ricardo-de-andrade/gemini-robot-pi5/3dprint/Raspberry Cover - Jetpack.3mf

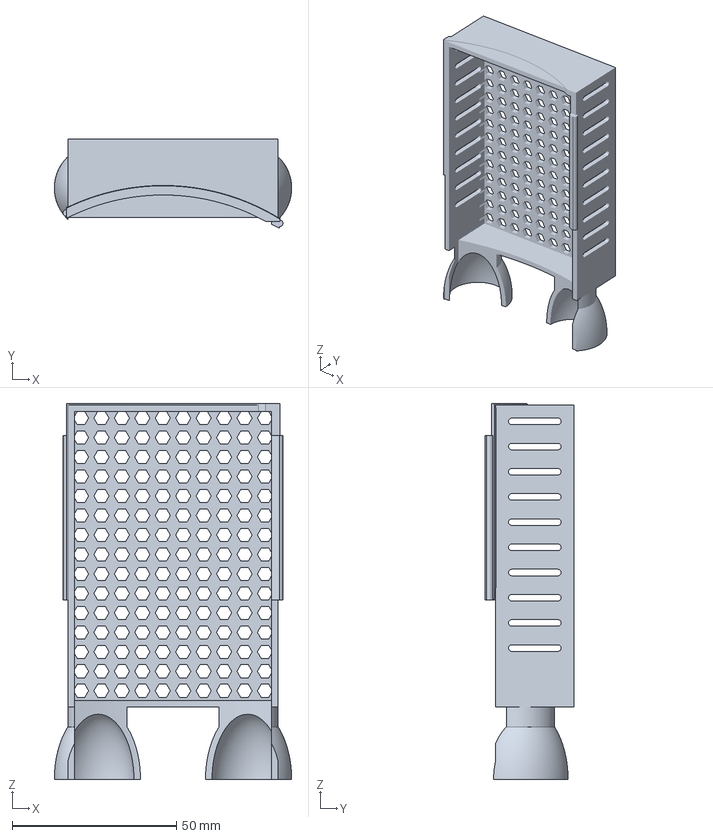
[picture p1: CAD file, 2026-10-08]
3dprint/Raspberry Cover - Jetpack.3mf
72.2 x 27.2 x 114.4 mm
