ricardo-de-andrade/gemini-robot-pi5/3dprint/BugDroid - Legs.3mf

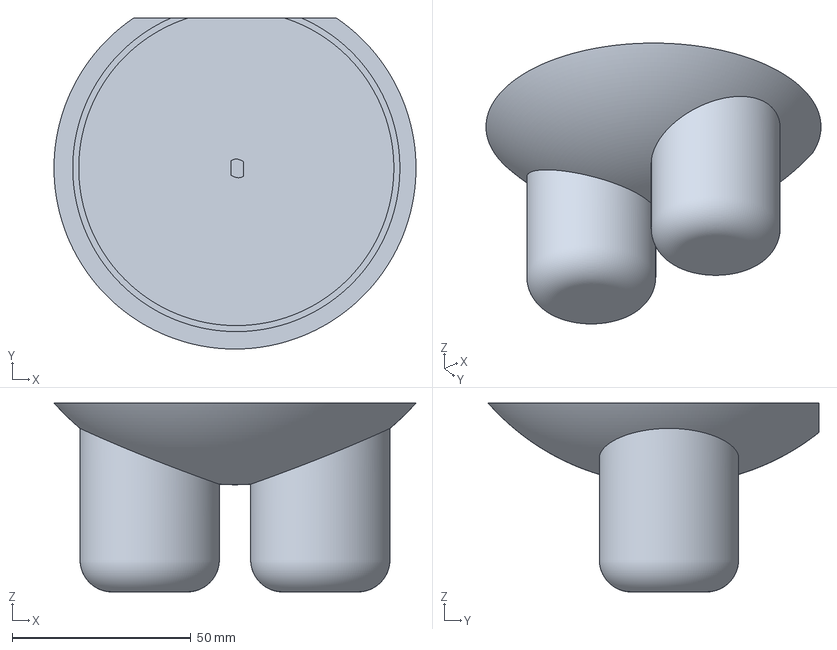
[picture p2: CAD file, 2026-10-08]
3dprint/BugDroid - Legs.3mf
101.3 x 92.7 x 52.9 mm
