ricardo-de-andrade/gemini-robot-pi5/3dprint/BugDroid - Arms.3mf

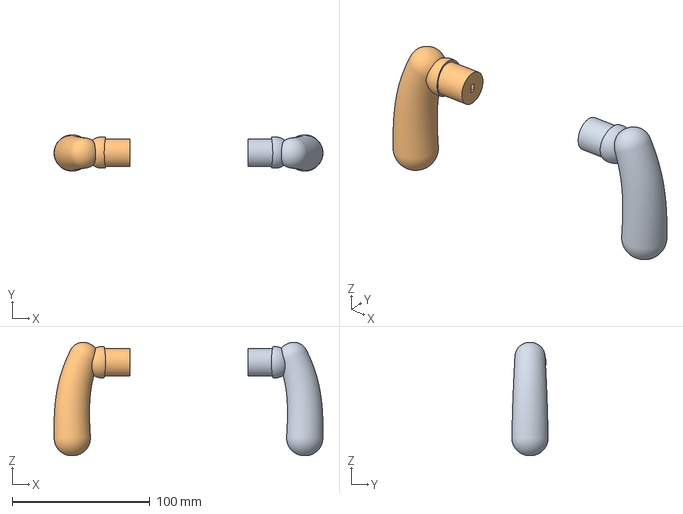
[picture p3: CAD file, 2026-10-08]
3dprint/BugDroid - Arms.3mf
195.6 x 26.4 x 82.5 mm
Left Arm
Right Arm
