ricardo-de-andrade/gemini-robot-pi5/3dprint/Motor Mount.3mf

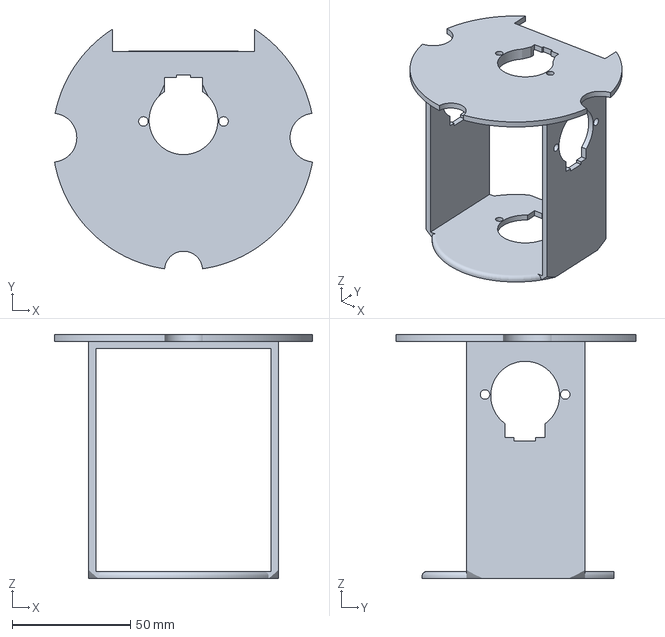
[picture p4: CAD file, 2026-10-08]
3dprint/Motor Mount.3mf
108.9 x 101.1 x 103.0 mm
