ricardo-de-andrade/gemini-robot-pi5/3dprint/BugDroid - Head.3mf

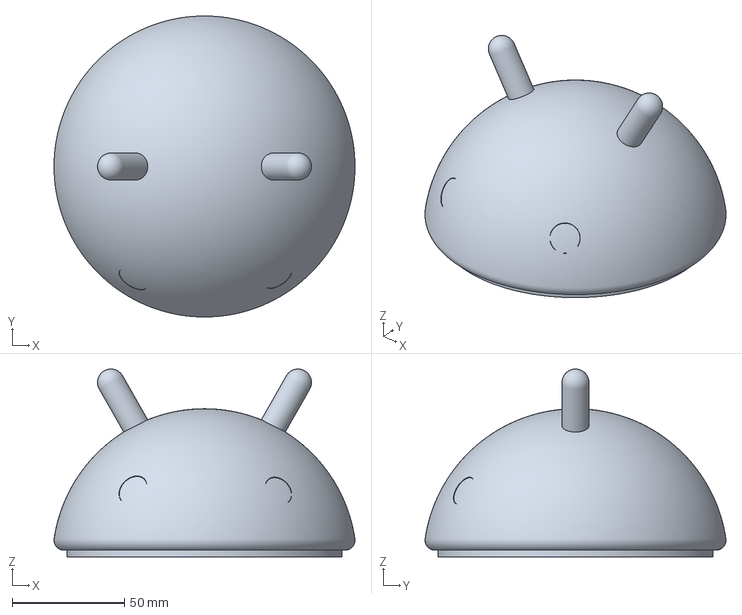
[picture p5: CAD file, 2026-10-08]
3dprint/BugDroid - Head.3mf
134.0 x 134.0 x 83.7 mm
