ricardo-de-andrade/gemini-robot-pi5/3dprint/BugDroid - Body.3mf

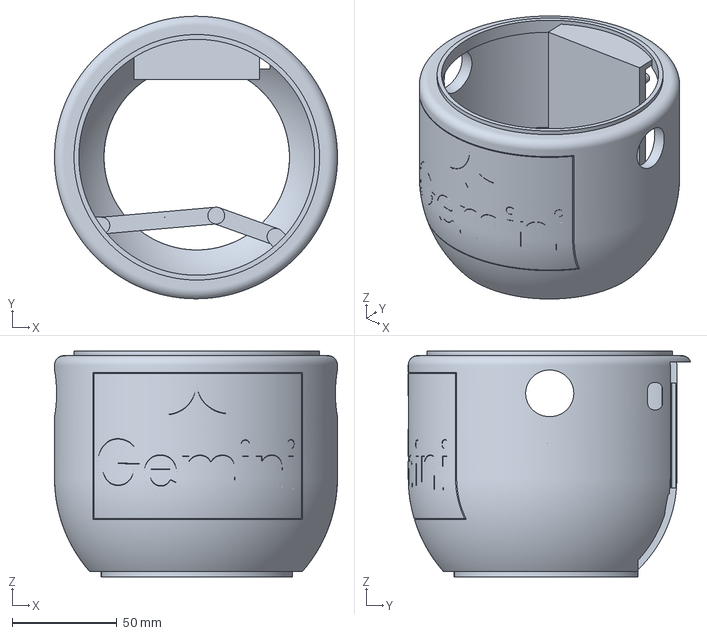
[picture p6: CAD file, 2026-10-08]
3dprint/BugDroid - Body.3mf
135.0 x 134.8 x 107.8 mm
