ricardo-de-andrade/gemini-robot-pi5/3dprint/Android.stl

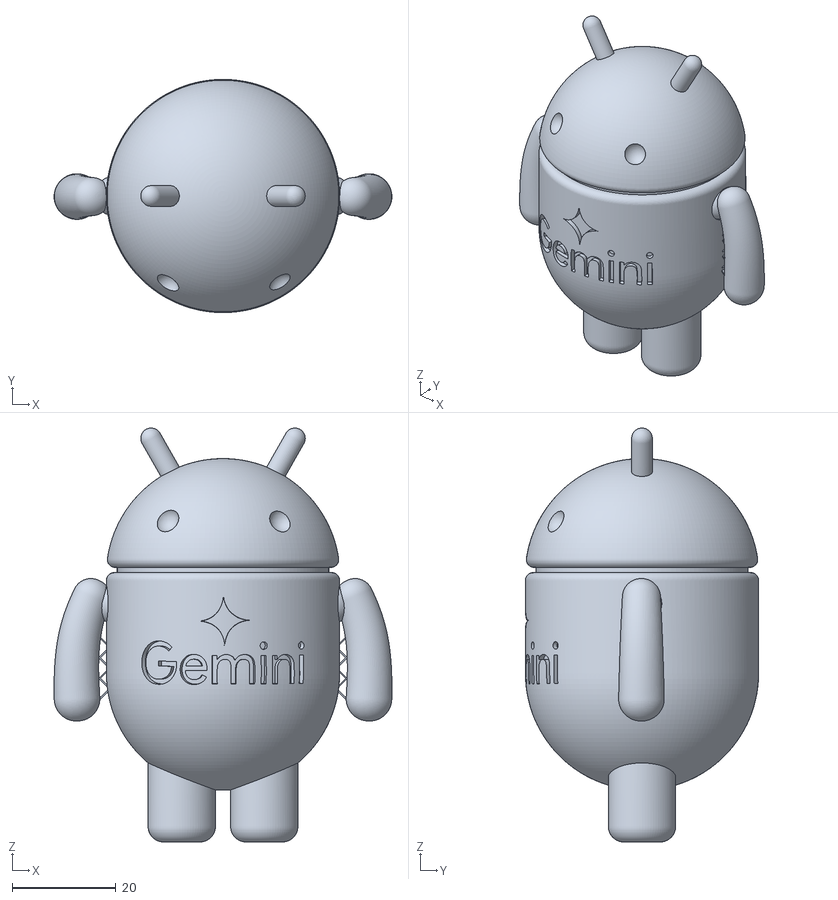
[picture p7: CAD file, 2026-10-08]
3dprint/Android.stl
65.2 x 45.0 x 79.9
