ricardo-de-andrade/gemini-robot-pi5/(commit log)

2026-10-08 Initial commit: Raspberry Pi 5 Gemini Live Robotics Agent
2026-10-08 Added 3D print files
    [Android.stl, BugDroid - Arms.3mf, BugDroid - Body.3mf, BugDroid - Head.3mf, BugDroid - Legs.3mf, Motor Mount.3mf, Raspberry Cover - Jetpack.3mf]
